efimova-d/DZ_SAPR/DZ_SAPR.kicad_pcb

## KiCad design DZ_SAPR.kicad_pcb (2026-11-04)

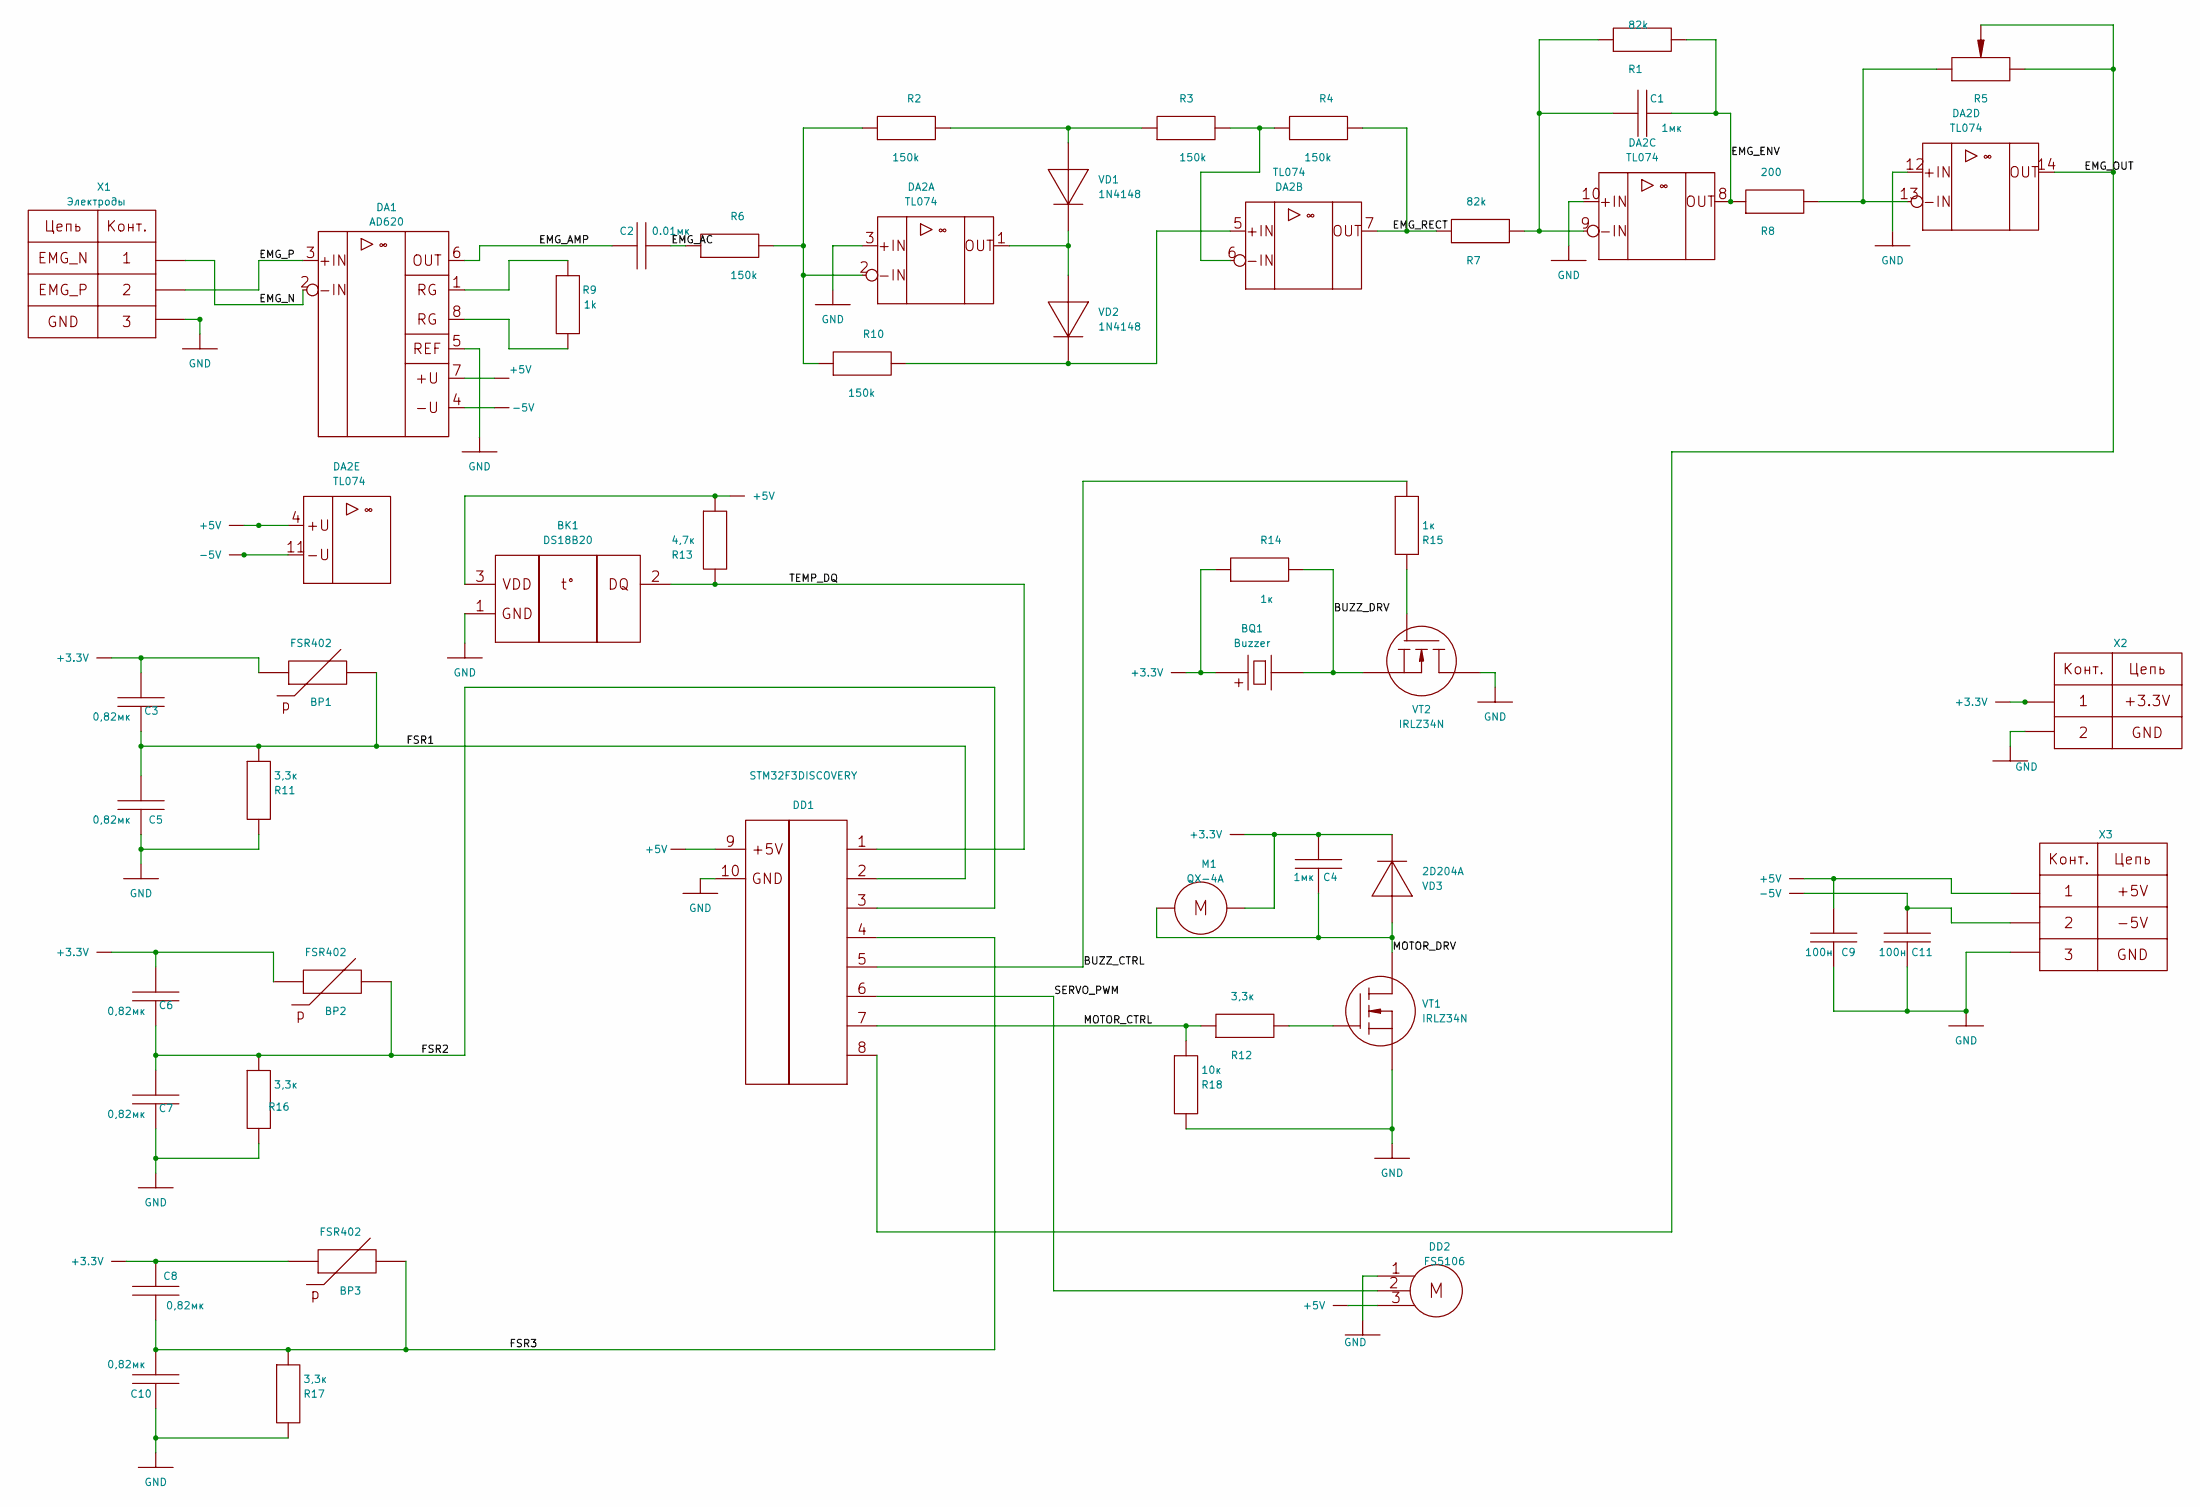
[picture p1: schematic DZ_SAPR.kicad_sch, Протез кисти руки миоэлектрический с обратной связью]

Parts:
BK1: DS18B20; TO-92_Inline; Manufacturer_Part_Number DS18B20+
BP1, BP2, BP3: FSR402; PinHeader_1x02_P2.54mm_Vertical; Manufacturer_Part_Number 30-81794
BQ1: Buzzer; Buzzer_Murata_PKLCS1212E; Manufacturer_Part_Number PKLCS1212E4001-R1
C1, C4: 1мк; C_0805_2012Metric; Manufacturer_Part_Number CL21B105KBFNNNE
C2: 0.01мк; C_0805_2012Metric; Manufacturer_Part_Number CL21B103KBANNNC
C3, C5, C6, C7, C8, C10: 0,82мк; C_0805_2012Metric; Manufacturer_Part_Number C0805X824K3RACAUTO
C9, C11: 100н; C_0805_2012Metric; Manufacturer_Part_Number CL21B104KBCNNNC
DA1: AD620; SO-8_3.9x4.9mm_P1.27mm; Manufacturer_Part_Number AD620ARZ
DA2: TL074; SO-14_3.9x8.65mm_P1.27mm; Manufacturer_Part_Number TL074CDR
DD1: STM32F3DISCOVERY; PinHeader_1x10_P2.54mm_Vertical; Manufacturer_Part_Number STM32F3DISCOVERY
DD2: FS5106; PinHeader_1x03_P2.54mm_Vertical; Manufacturer_Part_Number FS5106B
M1: QX-4A; PinHeader_1x02_P2.54mm_Vertical; Manufacturer_Part_Number QX-4A
R1, R7: 82k; R_0805_2012Metric; Manufacturer_Part_Number RC0805FR-0782KL
R2, R3, R4, R6, R10: 150k; R_0805_2012Metric; Manufacturer_Part_Number RC0805FR-07150KL
R5: 10к; Potentiometer_Bourns_3266W_Vertical; Manufacturer_Part_Number 3266W-1-103LF
R8: 200; R_0805_2012Metric; Manufacturer_Part_Number RC0805FR-07200RL
R9: 1k; R_0805_2012Metric; Manufacturer_Part_Number RC0805FR-071KL
R11, R12, R16, R17: 3,3к; R_0805_2012Metric; Manufacturer_Part_Number RC0805FR-073K3L
R13: 4,7к; R_0805_2012Metric; Manufacturer_Part_Number RC0805FR-074K7L
R14, R15: 1к; R_0805_2012Metric; Manufacturer_Part_Number RC0805FR-071KL
R18: 10к; R_0805_2012Metric; Manufacturer_Part_Number RC0805FR-0710KL
VD1, VD2: 1N4148; D_DO-35_SOD27_P7.62mm_Horizontal; Manufacturer_Part_Number 1N4148
VD3: 2D204A; D_DO-35_SOD27_P7.62mm_Horizontal; Manufacturer_Part_Number 2Д204А
VT1, VT2: IRLZ34N; TO-220-3_Vertical; Manufacturer_Part_Number IRLZ34NPBF
X1: Электроды; PinHeader_1x03_P2.54mm_Vertical; Manufacturer_Part_Number 61300311121
X2: Conn_01x02_Pin; PinHeader_1x02_P2.54mm_Vertical; Manufacturer_Part_Number 61300211121
X3: Conn_01x03_Pin; PinHeader_1x03_P2.54mm_Vertical; Manufacturer_Part_Number 61300311121

Connections:
+3.3V: BP1.1, BP2.1, BP3.1, BQ1.1 (+), C3.2, C4.2, C6.2, C8.2, M1.1, R14.1, VD3.1 (K), X2.1 (+3.3V)
+5V: BK1.3 (VDD), C9.2, DA1.7 (+Vs), DA2.4 (V+), DD1.9 (+5V), DD2.3 (+), R13.1, X3.1 (+5V)
-5V: C11.2, DA1.4 (-Vs), DA2.11 (V-), X3.2 (−5V)
/BUZZ_CTRL: DD1.5, R15.1
/BUZZ_DRV: BQ1.2 (-), R14.2, VT2.3 (S)
/EMG_AC: C2.2, R6.1
/EMG_AMP: C2.1, DA1.6 (OUT)
/EMG_ENV: C1.2, DA2.8 (OUT), R1.2, R8.1
/EMG_N: DA1.2 (-IN), X1.1 (EMG_N)
/EMG_OUT: DA2.14 (OUT), DD1.8, R5.2, R5.3
/EMG_P: DA1.3 (+IN), X1.2 (EMG_P)
/EMG_RECT: DA2.7 (OUT), R4.2, R7.1
/FSR1: BP1.2, C3.1, C5.2, DD1.2, R11.1
/FSR2: BP2.2, C6.1, C7.2, DD1.3, R16.1
/FSR3: BP3.2, C8.1, C10.2, DD1.4, R17.1
/MOTOR_CTRL: DD1.7, R12.1, R18.1
/MOTOR_DRV: C4.1, M1.2, VD3.2 (A), VT1.2 (D)
/SERVO_PWM: DD1.6, DD2.2 (S)
/TEMP_DQ: BK1.2 (DQ), DD1.1, R13.2
GND: BK1.1 (GND), C5.1, C7.1, C9.1, C10.1, C11.1, DA1.5 (REF), DA2.3 (+), DA2.10 (+), DA2.12 (+), DD1.10 (GND), DD2.1 (-), R11.2, R16.2, R17.2, R18.2, VT1.3 (S), VT2.2 (D), X1.3 (GND), X2.2 (GND), X3.3 (GND)
unnamed: DA1.1 (RG), R9.1
unnamed: DA1.8 (RG), R9.2
unnamed: DA2.2 (-), R2.1, R6.2, R10.1
unnamed: DA2.5 (+), R10.2, VD2.1 (K)
unnamed: DA2.6 (-), R3.2, R4.1
unnamed: C1.1, DA2.9 (-), R1.1, R7.2
unnamed: DA2.13 (-), R5.1, R8.2
unnamed: R2.2, R3.1, VD1.2 (A)
unnamed: DA2.1 (OUT), VD1.1 (K), VD2.2 (A)
unnamed: R12.2, VT1.1 (G)
unnamed: R15.2, VT2.1 (G)

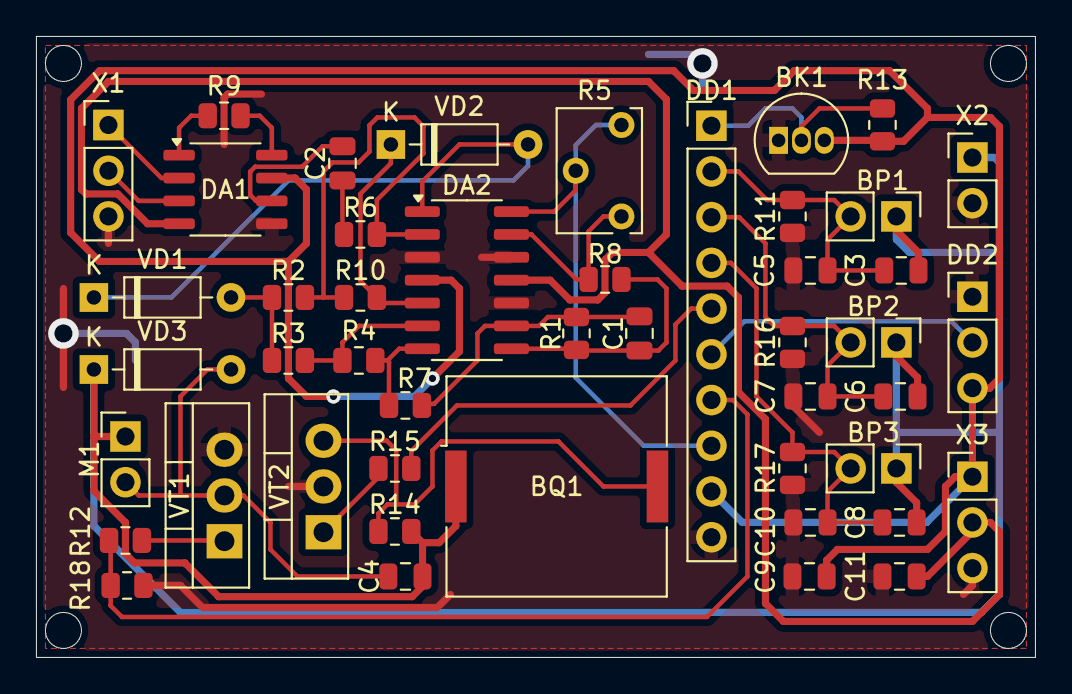
[picture p2: board DZ_SAPR.kicad_pcb from above]

Board: 2 copper layers, 55.5 x 34.5 mm, 47 parts (0 on the bottom side), 31 nets.
